lachmart/rc-lap-timer/enclosure/lap timer.3mf

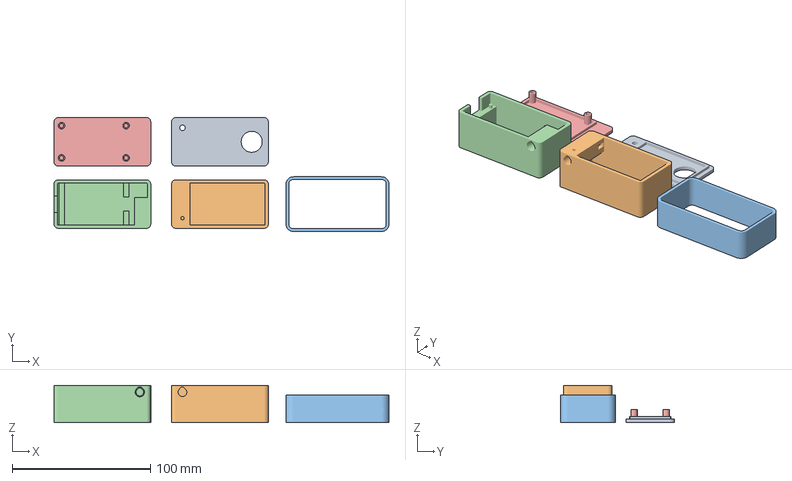
[picture p1: CAD file, 2026-11-04]
enclosure/lap timer.3mf
241.9 x 82.2 x 26.9 mm
Laser lid
Laser post
Sleeve
Timer base
Timer lid
