lachmart/rc-lap-timer/src/config.h

// Fixed firmware settings
#pragma once
#include <stdint.h>

constexpr int      SENSOR_PIN  = 32;              // ADC1 only (GPIO 32–39), ADC2 can't be used with Wi-Fi on
constexpr int      LED_PIN     = 2;               // onboard blue LED, lit while the beam is broken
constexpr int      IR_PIN      = 33;              // IR receiver TSOP38238 output (D33, next to D32)
constexpr const char* AP_SSID  = "RC_Lap_Timer";
constexpr const char* AP_PASS  = "";              // empty = open network, otherwise at least 8 characters
constexpr const char* HOSTNAME = "laptimer";      // http://laptimer.local
constexpr const char* OTA_PASSWORD = "laptimer";  // Wi-Fi firmware upload, must match upload_flags in platformio.ini
constexpr int      MAX_LAPS    = 400;             // recent laps kept in memory (a race needs all of its laps; ~10 KB)
constexpr int      MAX_DRIVERS = 8;
constexpr int      MAX_CARS    = 8;               // car slots: 0 = beam-only car, 1..7 transponder cars
constexpr int      MAX_NAME    = 32;              // bytes (UTF-8) per driver name, UI allows 16 characters
constexpr uint32_t DEF_MIN_LAP = 2000;            // ms, shorter passes are ignored
constexpr int      DEF_DELTA   = 800;             // how far the ADC value must deviate from idle
constexpr uint32_t STA_TIMEOUT = 10000;           // ms, how long one attempt to join the home Wi-Fi lasts
constexpr uint32_t STA_RETRY   = 30000;           // ms, pause between attempts to join the home Wi-Fi
constexpr uint32_t RACE_COUNTDOWN_MS = 4000;     // race start: "get ready", 3, 2, 1, go
constexpr uint32_t LIVE_EVERY  = 200;             // ms, live sensor data to the browser
