lachmart/rc-lap-timer/(commit log)

2026-11-02 RC lap timer: ESP32 laserová závora s webovou aplikací
    - měření v samostatném FreeRTOS tasku, automatická kalibrace klidu
    - WebSocket pro okamžité časy, záložní HTTP polling
    - captive portal a volitelné připojení k domácí Wi-Fi (laptimer.local)
    Claude-Session: https://claude.ai/code/session_01F3neq1H1aNrwMK9hrj4wWZ
2026-11-02 Split firmware into modules, move web page to web/, translate to English
    - src/: main, config, settings, sensor, laps, wlan, web modules
    - web/index.html, style.css, app.js embedded via board_build.embed_txtfiles
    - wlan instead of network: avoids shadowing the framework's Network.h on macOS
    - comments, UI, docs in English; first successful build
    [config.h, laps.cpp, laps.h, main.cpp, sensor.cpp, sensor.h, settings.cpp]
2026-11-03 Drivers leaderboard, lap corrections, background home Wi-Fi, tests, mock server
    - drivers: names saved in flash, select who's driving, laps attributed per driver,
    per-session leaderboard (best, gap, laps, avg); switching driver drops the lap in progress
    - corrections: undo last pass, restart lap, delete lap, join two laps split by a
    false trigger; "short?" marker for suspicious laps
    - home Wi-Fi joined in the background with retries while nobody is on the own AP,
    live status in the UI
    - onboard LED (GPIO 2) shows the beam state
    - voice announcements (speechSynthesis) next to the beep
    - JSON string escaping instead of stripping quotes from the SSID
    - laps.cpp free of hardware deps; 25 U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
    [config.h, drivers.cpp, drivers.h, laps.cpp, laps.h, main.cpp]
2026-11-03 Better Wi-Fi: network scan, no restart, failure reasons, signal bars
    - scan nearby networks and pick one instead of typing the name
    - home network changes apply without restarting the timer, RC_Lap_Timer stays up
    - show why joining failed (wrong password / network not found)
    - keep the saved password when the field is left empty
    - signal strength bars and status summary in the collapsed Wi-Fi section
    - mock server simulates scan, connect outcomes and signal
    [web.cpp, wlan.cpp, wlan.h]
2026-11-03 Sensor tuning help, beam-blocked warning, big view, remembered sound
    - beam detection moved into a hardware-free Beam class with 11 unit tests
    - noise and pass depth measured live; suggested sensitivity with one-tap apply
    - no-trigger band on the sensor bar
    - warning when the beam stays broken for more than 3 s
    - big view for a phone propped up at the track (fullscreen where allowed)
    - beep/voice switches remembered per phone, unlocked on the first tap
    - state is pushed when the Wi-Fi failure reason changes
    - mock: tuning values, /mock/block
    [beam.cpp, beam.h, sensor.cpp, sensor.h, web.cpp]
2026-11-03 Bigger app partition, Wi-Fi firmware upload, faster lap list, sensor hardware tip
    - partition table min_spiffs: 1.9 MB app (flash use 89 % -> 62 %), settings survive
    - ArduinoOTA with password, env "ota" for pio run -e ota -t upload
    - lap list computes per-driver medians once per update instead of per lap
    - README: LDR response time vs. fast cars, phototransistor drop-in alternative
2026-11-03 app.js: txLabel() and countedLaps() helpers, NEC_ID_MIN and MAX_DRIVERS constants
    The transponder label and the per-car counted-laps filter were written out three
    and two times; the driver limit was a bare 8.
2026-11-03 mock_server: match the firmware for /api/config and removed drivers
    /api/config with minLap=0 or delta=0 now clamps to the minimum like
    handleConfig() instead of keeping the old value, and removing a driver drops
    their stats like lapsForgetDriver().
2026-11-03 race.js exports the lap fields (L) and racers(), app.js uses them
    The lap entry layout and the which-cars-race rule were defined in both files.
    Also fixes the test command in race.test.js (node --test needs the file glob).
    [web.cpp]
2026-11-03 lines.h: one newline-list parser for cars.cpp and drivers.cpp
    Same results as the two old parsers (compared on the host for edge cases:
    empty, trailing and blank lines, more lines than slots).
2026-11-03 ZRoundProto: ZRound protocol out of zround.cpp into a hardware-free, unit-tested class
    zround.cpp only moves bytes between Serial and the class. Switching the USB
    mode now also drops pending acks (fresh protocol state).
2026-11-03 Upload at 460800 baud: 921600 fails on the CH9102 board; first upload noted
2026-11-03 Web: drop an idle connection after 200 ms when another one waits
    WebServer serves one connection at a time and waits 5 s for its request.
    Spare connections from phone browsers made the page take 30 s+ to load
    (measured: 3 idle sockets = 15 s per request, now 0.6 s).
2026-11-03 Heats: one car, drivers in turn, each N laps, automatic handover
    With one car and a laps race, the race setup shows the drivers in turn (tap to
    leave out / reorder). The firmware hands car 0 to the next driver after the
    current one's N-th counted lap; their time starts at the next crossing (one
    untimed lap to hand over the transmitter). Standings by total time of the N laps.
    JSON race.order/race.heat, /api/race/start&order=; mock mirrors it.
    Tests: RaceClock heats, lapsCountOf, webjson, race.js heat standings.
2026-11-03 Heats: live panel for the driver on the track, who is next, voice cues
    Race card in heats: driver, lap n/N, running lap and heat total to the ms
    (every frame), last/best, split vs the fastest heat after the same laps,
    laps to go / FINAL LAP / take the transmitter, next driver (highlighted
    "get ready" on the final lap and before go) and the rest of the order.
    Voice: final lap + next get ready, heat result with position, your turn.
    Big view shows the same.
2026-11-03 Race card: undo the last pass; in heats it also undoes the handover it caused
    The race card (one car) gets "Remove last time x.xxx" / "Undo start pass".
    A heat handover now keeps the last pass undoable (lapsSetDriver handOver);
    timingUndo gives the car back to the previous driver and reopens their heat.
    Mock mirrors it; laps + RaceClock tests.
    Sensor hint no longer says "missed passes" when the setting still catches
    passes: it says whether it works, has little margin, misses or is near noise.
    First heat: "The time starts at the first crossing".
    [cars.cpp, cars.h, laps.cpp, laps.h, raceclock.h]
2026-11-03 Beam-blocked warning: Calibrate now button, also shown on the race card
    A stale idle value (calibrated without the laser on the sensor, e.g. at
    power-up) looks like a permanently blocked beam; the warning now says so and
    calibrates with one tap. During a race the warning was hidden with the
    training cards; the race card has it too.
2026-11-03 Race card: Race again after a finished race (same length and heat order)
2026-11-03 App redesign: Training / Race / Settings tabs, driver chips, timing colours
    - Bottom tab bar: Training (timer, drivers, leaderboard, laps), Race (setup with
    a length stepper, or the running race with the laps list), Settings (cars,
    sensor, Wi-Fi, USB). The Race tab opens when a race starts; Training shows a
    banner meanwhile and hides the driver picker.
    - Drivers: tap a chip to drive, "+ Add driver" opens a name field in place,
    Edit turns chips into remove buttons. Several cars: "Who drives which car".
    - Look: slate night palette, purple = session best, green = personal best,
    yellow = attention, red = stop; DIN digits where the phone has them.
    - Buttons in a row are equal height; ra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
2026-11-03 Tabs at the top; add and remove drivers in race setup
    Tabs moved under the title in the sticky header (bottom bar was hard to find).
    Race setup: + Add driver and Edit (remove) next to the heat order; a driver
    added there joins the end of the order. With several cars the Drivers card
    (who drives which car) is shown in race setup too.
2026-11-03 Voice: obvious on/off switch, speech that survives phone browsers
    The Beep/Voice pills show 🔊/🔇 and fill green when on (the redesign left
    only a thin border). say() no longer cancel()s and speaks in the same moment
    (iOS Safari drops that utterance): it cancels only when something is being
    said and speaks 60 ms later, in order; race messages that come together
    (heat result, next driver, final lap, winner) queue instead of cutting each
    other off. The first-tap unlock doesn't fire on the Voice switch itself.
    Header fits 375 px phones (connection text hidden, the dot stays).
2026-11-03 Beep/Voice switches without emoji: filled green = on
2026-11-03 Voice: keep utterances alive until they end, show when the browser doesn't speak
    Chrome on macOS got into a state where speech was accepted but never played
    (also for a plain speak() on a fresh page, until Chrome was restarted).
    Hardening: utterances are referenced until end/error (Chrome stalls when one
    is garbage-collected early), resume() before speak, no cancel()+speak() in the
    same moment for the switch, the first-tap unlock is an empty utterance again
    (as before the redesign). If a message doesn't start within 4 s the Voice
    switch turns red with a hint to restart the browser.
2026-11-03 Heats: prep time or Start button between drivers, countdown with the name, one voice message per crossing
    Between heats the next driver gets ready: the race waits for "Start <name>"
    (/api/race/next) or counts down the prep time set in race setup (10/30/60 s,
    "Start now" cuts it short); then the driver's name, 3, 2, 1, go. Crossings
    before that heat's go don't count (RaceClock HeatState, unit-tested; mock
    mirrors it; JSON race.heatState/heatGo/prep).
    Voice in heats: one message per crossing (lap time + final lap + who gets
    ready, or the finished heat with total, position and who's next, or the
    winner), so messages no longer cut each other off. Undo says "Last pass
    removed" and who drives on.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
    [raceclock.cpp, raceclock.h, timing.cpp, timing.h]
2026-11-03 Heat voice: no "Jana, get … Jana"
    The countdown's name cut off the heat result that ends with "<name>, get ready".
    The countdown no longer says the name while that message is still being read;
    tapping Start interrupts it on purpose and says the name, then 3, 2, 1, go.
    The heat result is shorter (no lap time) so it ends before a prep countdown.
2026-11-03 Race card: one clear instruction; voice: short messages that never cut each other off; race over = timer stops
    - The race card shows one big instruction for every moment, coloured by what
    to do (yellow: line up / get ready / final lap, green: GO): "Martin, line
    up", "Martin, GO!", "Martin: 2 laps to go", "Martin: FINAL LAP" + "Jana, get
    ready, you're next", "Jana, take the transmitter", "Jana, get ready",
    "Race finished" + winner. Up next shows the order. Big view shows it too.
    - Voice rewritten simple: say() only queues (no cancel, nothing cut off);
    messages: countdown (heats: name first) 3, 2, 1, go; lap times; "final lap";
    "<next> next"; "race finished". No positions, totals,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
    [raceclock.cpp, timing.cpp, timing.h]
2026-11-03 Big view fits any screen (phone upright/sideways, laptop, TV); larger page on big screens
    Big view sizes everything in em from one font size; fitBig() starts at 7 %
    of the shorter side and shrinks until nothing overflows (on open, resize,
    content change, and when the running time gains a digit). Heats show the
    instruction, the running lap, the heat total and who's next (standings stay
    on the card). Landscape phones: the header scrolls away. Laptop/TV: the page
    is zoomed 1.35x.
2026-11-03 Clean-up after a UI and a race-director review
    Race rules (web/race.js, tested):
    - Time race: every car finishes at its own first crossing after the time
    (club rules); a parked leader no longer keeps the race open.
    - DNF: a started car that stops crossing after the race is decided is out
    after max(30 s, 2 best laps), so the race can finish.
    - Race time counts from GO, so the Time column matches the order.
    - Heats: a tie goes to the better best lap.
    - Lap memory 200 -> 400 (a race needs all its laps).
    Race card (raceview.js rewritten):
    - One instruction says who does what; title stays put ("Heat 2 of 3",
    "Race · 10 laps"); countdown shows digits and GO only; no name/laps
    repeated in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
    [config.h]
2026-11-03 enclosure: Fusion 360 script for the timer box (pin plate, USB slot, LDR tube) and laser post (2xAA, switch, aimable laser)
    Not yet run in Fusion.
2026-11-04 enclosure: LDR tube inside the box, frame starts at the pin plate (prints plate-down), bottom becomes a tray
    - The LDR tube runs from the inside of the front wall inwards; light comes in
    through a small funnel-shaped opening. Nothing sticks out of the box.
    - The timer frame starts at the pin plate, so the plate lies on the print bed
    (straight pin holes, no supports); anything below it is trimmed flat.
    - The room under the plate for Dupont plugs and wires moves into a taller
    bottom tray; the frame stands on a ledge in it, a 3 mm rim goes around it.
2026-11-04 enclosure: LDR in the base, flush stepped joint above the beam, plate is the box floor
    - The timer is now a box (upper part, floor = pin plate, prints plate-down)
    on a base (lower part) with the same outline. They join with a stepped
    edge: the base's outer wall half rises 3 mm into a recess in the box, so
    the outside is flush.
    - The LDR tube (a block standing on the base floor, prints without supports)
    and the beam opening are in the base, well below the joint, so nothing can
    block the beam; the opening is 9 mm again.
    - All wiring (LDR, resistor, Dupont plugs on the pins) is in the base.
    Walls 2.4 mm so they split in half for the joint.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
2026-11-04 enclosure: redesign for clean FDM printing and a nicer look
    Five parts, each lying the way it prints, no supports:
    - Timer base: rounded tray; LDR tube block on the floor with a teardrop bore
    and teardrop funnel behind the beam opening; 4 posts (tied to the walls)
    for the pin plate; USB slot from the top edge.
    - Pin plate: own flat part (pin holes print vertical), 4x M3 screws beside
    the board, below the header spacer height.
    - Timer lid / Laser lid: flat, with a lip; a groove on top marks the beam line.
    - Laser post: rounded; teardrop laser bore at beam height, M3 aiming screws
    top and side, wire channel; the switch hole is in the lid (prints flat).
    Rounded corners throughout, 2.4 m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
2026-11-04 CLAUDE.md: mention the enclosure script
2026-11-04 enclosure: smaller, both parts share one footprint and height, transport sleeve
    - Shared outer size computed from what each part needs (now 77 x 38 x 35 mm
    + 2.5 mm lid); the timer is 12 mm narrower, the laser post 24 mm shorter.
    - Pin plate only as wide as the inside: a tongue goes into a slot in the USB
    end wall, two M3 screws hold its tab past the board's antenna end.
    - LDR tube shorter and thinner; it sits in the 13 mm past the plate.
    - Laser post: the switch hangs from the lid over the battery holder (no
    separate switch room); the laser tower uses the space past the holder.
    - Sleeve: a ring that holds the two parts bottom to bottom for transport.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
2026-11-04 enclosure: 30 mm tall instead of 38 (height now set by the beam)
    - Laser post: the laser sits in a bridge across the battery holder's far end,
    4 mm above the holder (the holder slides in under it); the switch has its
    own zone at the other end, so it no longer stacks on the holder. Thinner
    floor under the holder; the script checks the holder fits under the bridge.
    - Timer: room under the pin plate for soldered wires (3 wires) instead of
    Dupont plugs; LDR tube 8 mm; the lid's lip has a notch over the tube.
    - Lid lips 2 mm; beam opening 7 mm so its teardrop stays below the lid.
    Both parts 86 x 38 x 28 mm + 2.5 mm lid.
2026-11-04 enclosure: laser bore closed at the back, wire slot into the pocket, screws over the laser
    The laser bore ran through both walls and its wires had no way into the post.
    Now the laser goes in from the front, the back wall stays closed, and a slot
    at the back of the bore drops the wires through the bridge into the battery
    and switch pocket. Both aiming screws press on the middle of the laser
    (laser_len, measure it), the lid's access hole follows.
2026-11-04 enclosure: laser and LDR opening line up when the parts face each other
    The laser post is mirrored: the laser bridge spans the holder's end at x = 0
    (flush with the end wall, the side aiming screw goes through it), the switch
    zone is at the other end. The timer's LDR opening is the same distance from
    its far end (beam_x), so standing face to face, one turned half way, the beam
    goes straight across and the lid grooves line up. The LDR tube is tied to the
    end wall below the lid's lip; the script checks it fits.
2026-11-04 enclosure: slimmer laser bridge (9 mm), LDR tube to the end wall, 3 mm corners
    The bridge is the laser bore + 1.2 mm each side (checked). The beam line moves
    closer to the end, so the timer's LDR tube block reaches the end wall and the
    lid's lip is left out over that corner; corners are 3 mm so both beam
    openings stay on the flat walls (checked).
2026-11-04 enclosure: laser carrier as its own part, no print span over the battery holder
    The laser block over the holder's end was a ~33 mm print bridge. Now it's a
    separate laser carrier: printed standing on its front face, so the bore is
    vertical (round, no teardrop) and nothing spans. It drops into two vertical
    grooves in the post's front and back walls and rests on their bottoms above
    the holder; the lid holds it down. Aiming screws: from the top through the
    lid, and through the post's end wall into the carrier; the laser's wires
    leave through a slot at its back. The post has a 5 mm beam hole in the front
    wall. Assembly: holder in, laser into the carrier, carrier in, lid on.
    Both parts now 86 x 3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
2026-11-04 enclosure: ESP32 clips in on its mounting holes, no pin plate
    The board sits on four standoffs with pegs through its mounting holes and a
    springy snap hook (45 deg lead-in, 1 mm catch) over its antenna end; push the
    hook back to take it out. Its pins point down between the standoffs, the
    wires are soldered underneath. The pin plate, its tongue slot and posts are
    gone. Hole spacing/diameter are parameters to measure.
2026-11-04 enclosure: ESP32 DevKit V1 hole positions from the real-size drawing
    Board 51.8 x 28.2 mm, holes 2.8 mm, 2.2 mm in from both edges: 47.4 mm along
    and 23.8 mm across, centre to centre (Fritzing SVG on mischianti.org, matches
    a caliper measurement on the Fritzing forum). The pegs locate the board by
    its holes; the snap hook has 0.3 mm room as the board edges aren't precise.
2026-11-04 enclosure: mounting holes as measured on the actual board (46.6 x 23.3 mm, 2.8 mm)
2026-11-04 enclosure: board length 51.5 mm as measured (holes centred: 2.45 mm from the ends)
2026-11-04 enclosure: carriers on pegged standoffs, walls never thinned, lids with a full lip
    - Laser carrier: its own spot at the post's end on two standoffs (a peg, and
    an M3 screw so the aiming screw can't lift it); the battery holder moves
    next to it; no grooves cut into the walls, only a 5 mm beam hole.
    - LDR carrier: a separate part like the laser's, printed standing (round
    bore and funnel), on two pegged standoffs behind a 7 mm beam hole; the
    timer's front wall is no longer thinned.
    - Both lids have their lip all the way round; the carriers end just below it.
    Both parts 97 x 38 x 29 mm + lid.
2026-11-04 enclosure: expert redesign - solid laser/LDR blocks, ESP ribs, lower, simpler assembly
    - No separate carriers or column standoffs: the laser and the LDR sit in
    solid blocks standing on the floor (one piece with their box, nothing to
    assemble or wobble), bores are teardrops with a small flat top (no
    supports, little height). Laser: in from the front, wires through a
    channel into the pocket, aiming screws top and end.
    - The ESP32 clips onto two solid cross-ribs under its ends (pegs in the
    mounting holes, the snap hook); the antenna-end rib has a wire gap.
    - Lids: the lip is a closed loop around the open part; the blocks' tops
    carry the lid where there is no lip. The beam groove on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
2026-11-04 enclosure: lid holds the ESP32 down with tubes around the pegs, no snap hook
2026-11-04 enclosure: 2×AAA holder and a 15.2 mm switch, both parts 10 mm shorter and 3 mm narrower
2026-11-04 enclosure: 12 mm switch over the battery holder's end, no switch zone: both parts 70 mm long
2026-11-04 enclosure: laser module is 10 mm long (measured)
2026-11-04 enclosure: snug 6.3 mm laser bore
2026-11-04 enclosure: hollow under the laser block, open to the battery pocket (as Martin modelled it)
2026-11-04 enclosure: 2.4 mm roof between the hollow and the laser bore
2026-11-04 enclosure: the hollow under the laser cuts away the pocket's corner rounds
2026-11-04 Create lap timer.3mf
    [lap timer.3mf]
